mprosk/kosmo-lib/README.md

# kosmo-lib
Shared library for KiCAD symbols and footprints used in my modular synthesizer designs

The KiCAD project file is present only for convenient editing of the library outside of a submodule
