mprosk/kosmo-lib/(commit log)

2022-05-17 Update footprints
2022-05-23 Add footprint for Kailh Choc
2022-06-01 Add footprints for minidrone aux panel
2022-06-03 Add matched diode and SATA connector
    [kosmo-lib.kicad_pcb, kosmo-lib.kicad_sch]
2023-01-21 Update and add footprints for valve distortion euro module
2023-02-02 Add footprint for valve socket
2023-02-14 Add symbol and footprint for 3-way jumper
2023-12-24 Add CUI SD-50BV vertical DIN MIDI connector
2023-12-24 Add 6N2P to symbol lib
    [kosmo-lib.kicad_pcb, kosmo-lib.kicad_sch]
2023-12-25 Add breadboard symbol and footprint
2023-12-25 Add 3d model to dpdt switch
2024-01-14 Update Breadboard footprint to be dimensionally accurate
